bear1023/logistics-robot/(list of files, drawings)

Other design files:
hardware/easyeda/物流车.epro
