bear1023/logistics-robot/firmware/USER/main.c

#include "stm32f4xx.h"
#include "usart.h"
#include "delay.h"
#include "board.h"
#include "Emm_V5.h"
#include "uart6_ckp.h"
#include "Serial.h"
#include "yyb_move.h"
#include "imu.h"
#include "PWM.h"
#include "LED.h"
#include "OLED.h"
#include "swith.h"
#include "pid.h"
#include "usart5.h"
#include "wit_c_sdk.h"
#include "exti.h"

//x减物块右移（从外侧往内看）//y+物块往地图内侧走
//x加物块左移（从外侧往内看）//y-物块往地图外侧走
#define  x_center_red       955+1
#define  y_center_red		519-8

#define  x_center_green		955-3
#define  y_center_green		519-8

#define  x_center_blue		955+1
#define  y_center_blue		519-8

char tjcstr[100];
int acc[4];
float direct_x = 0;
float direct_y = 0;
float distance_wukuai = 150;
float x_origin = 0;
float y_origin = 0;
float time_zhua = 0;
int task[6]; //存储颜色信息
int ypcode[6]; //存储颜色信息
int move[6]; //存储移动信息
int test11 = 0;
float angle = 0;

void transfer_pi_position11(uint8_t task_num);
void transfer_pi_position12(uint8_t task_num);
void transfer_pi_position2(void);
void transfer_pi_position3(uint8_t task_num);
void fangzhi_green(void);
void fangzhi_red(void);
void fangzhi_blue(void);
void fangzhi(uint8_t task);
void fangzhi_maduo(uint8_t task);
void na(uint8_t task);
void yuantai_na(uint8_t task);
void yuantai_na1(uint8_t task);
void yuantai_na2(uint8_t task);
void wait_send_shumeipai(uint8_t message,uint16_t time);
void clear_ckp(void);
void jixie_reset(void);
char message[] = "Hello, BT - 04 from STM32F407!\r\n";
int main(void)
{	
/*
	所有的中断：
		1.OLED每隔500ms更新角度数据（最好不启用，里面耗时很长）（会影响delay函数的调用正确与否）
		2.delayms1函数在启用时最好关闭所有中断
		3.PID每间隔50ms进行一次PID计算，花25ms给所有电机发送指令（耗时中等）
		4.IMU每次接受信息触发一次中断
		5.树莓派给stm32发送信息时触发中断
		6.步进电机到位时发送信息中断
		7.舵机控制每隔20ms定时控制角度
*/
	delay_init(168);
	board_init();  //配置can总线协议
	LED_Init();  //配置LED指示灯
	OLED_Init();   //暂时不启用OLED //OLED中断和TIM5绑定在一起（两个必须同时用）
	Timer6_Init(); //delayms1的时钟
	PWM_Init();	  //使用定时器二，开启中断，实时控制舵机角度
	uart5_init(9600);
	uart6_init(9600);//串口屏用的UART6
	Serial_Init();	//通讯串口1初始化，用UART1
	Swith_Init();   //开关初始化
	imu_init();     //使用UART2
	PIDInit();		//用定时器实现定时中断//周期为50ms//该中断最好不要被别的中断打断
	Key_EXTI_Init();//按键中断//向树莓派发送重启命令
    clear_ckp();    //清空串口屏
	dianji_move_flag = 1;//使能电机的运动
	TIM_SetCompare1(TIM3,0);  //关闭补光灯
//**************************测试代码***************************//
//	while(1){
//		LED_Toggle2();
//		delay_ms1(200);
//		if((Serial_RxPacket[0]==0x39) && (Serial_RxPacket[1]==0x38)){
//			break;
//	    }
//	}
//	while(swith_out() == 1){		
//		LED_Toggle2();
//		delay_ms1(50);
//	}//树莓派已经准备好，按下开关即可启动
//	//复位到识别的位置
//	task[0] = 0x02;task[1] = 0x01;task[2] = 0x03;
//	TIM_SetCompare1(TIM3,300);
//	move_all1(-120.0f,1000,200   ,0,1000,200   ,278.0f,13);
//	set_zhuashou_Angle(50.0f,200);
//	while(1){
//		wait_send_shumeipai(0x37,10000);//如果发送了信息，但是一直没有得到回应，那么就一直发送
//		transfer_pi_position11(0x02);
//		car_move_distance(direct_x,direct_y,180,150);
//		if(Serial_RxPacket[8] != 0x34){
//			break;
//		}
//		//如果返回了没看到的信息，那就微微调整一下，再重复给树莓派发送
//		//反之如果返回了看到的信息（也即第九位并非0x34）,则可以退出该程序
//	}	
//	//精细定标
//	{
//		wait_send_shumeipai(0x38,10000);//如果发送了信息，但是一直没有得到回应，那么就一直发送
//		transfer_pi_position12(0x02);	
//		if(Serial_RxPacket[8] == 0x34){
//			car_move_distance(0,0,70,50);//如果没有看到颜色，那就不移动
//		}else{	
//			car_move_distance(direct_x,direct_y,130,100);//如果看到颜色，那就按照正常的方式移动
//		}
//	}//至此第二次定标完成
//	move_all(-48.0f,1000,200   ,33,1000,200   ,135,13);//物块平台抓物块
//	set_zhuashou_Angle(6.0f,200);
//	//放置第一个
//	fangzhi(task[0]);
//	set_wukuaipingtai_Angle(20.0f+113.0f,300);
//	delay_ms1((int)shengjiang_control(33,2000,240));
//	move_all(-48.0f,1000,200   ,33,1000,200   ,135,13);//物块平台抓物块
//	set_zhuashou_Angle(6.0f,200);
//	
//	//放置第二个	
//	fangzhi(task[1]);
//	
//	set_wukuaipingtai_Angle(20.0f+113.0f+117.0f,300);
//	delay_ms1((int)shengjiang_control(33,2000,240));
//	move_all(-48.0f,1000,200   ,33,2000,200   ,135,13);//物块平台抓物块
//	set_zhuashou_Angle(6.0f,200);
//	
//	//放置第三个	
//	fangzhi(task[2]);
//	jixie_reset();//*****************
//*************************第一轮*************************//
	while(1){
		LED_Toggle2();
		delay_ms1(200);
		if((Serial_RxPacket[0]==0x39) && (Serial_RxPacket[1]==0x38)){
			break;
	    }
	}
//	test11 = WHT101_HUIFUHCUCHANG();
//	test11 = WHT101_SETBAUD();
//	test11 = WHT101_SETOUTRATE();
//**************************指示灯闪烁，可以开始***************************//
	while(swith_out() == 1){		
		LED_Toggle2();
		delay_ms1(50);
	}//树莓派已经准备好，按下开关即可启动
	mypid.integral = 0;
	WHT101_ANGLEZCali();//101z轴置零
	Serial_GetRxFlag();Serial_SendByte(0x31);
//***************************第一部分，识别二维码并显示，大致移动到原料区*********************//	
	//扫二维码
	car_move2(150,0,150,150);
	car_move1(0,-530,150,200);
    //读取树莓派信息	
	while(1){
		if (Serial_GetRxFlag() == 1){   //收到数据包
			   sprintf(tjcstr, "t0.txt=\"%d%d%d+%d%d%d \"",
										Serial_RxPacket[0]-0x30,Serial_RxPacket[1]-0x30,Serial_RxPacket[2]-0x30,
										Serial_RxPacket[4]-0x30,Serial_RxPacket[5]-0x30,Serial_RxPacket[6]-0x30);
				HMISends(tjcstr);
	            HMISendb(0xff);//在显示屏上面显示任务
				break;
			  }
	}	
    task[0]= Serial_RxPacket[0]-0x30;task[1] = Serial_RxPacket[1]-0x30;task[2] = Serial_RxPacket[2]-0x30;
	task[3]= Serial_RxPacket[4]-0x30;task[4] = Serial_RxPacket[5]-0x30;task[5] = Serial_RxPacket[6]-0x30;
	set_wukuaipingtai_Angle(20.0f,300);
//********************第二部分，识别物块颜色，按照指定的顺序搬运**************************//
	//复位到识别的位置
	move_all1(-120.0f,1000,200   ,0,2000,200   ,278,13);
	set_zhuashou_Angle(60.0f,300);
	car_move1(0,-1000+90,150,200);
	move_all1(40.0f,1000,200   ,0,2000,200   ,278,13);
	Serial_GetRxFlag();Serial_SendByte(0x32);
	car_move2(-30,0,100,100);	
	TIM_SetCompare1(TIM3,300);
	while(1){
		while(1){
			if(Serial_GetRxFlag() == 1){
				break;
			}
		}
		transfer_pi_position2();
		car_move_distance(direct_x,direct_y,100,80);//至此第一次定标完成
		if(Serial_RxPacket[8] != 0x34){
			break;
		}else{
			wait_send_shumeipai(0x32,15000);
		}
	}
	move_all(60.0f,1000,200   ,0,2000,200   ,278,13);
	wait_send_shumeipai(0x33,20000);
	ypcode[0]= Serial_RxPacket[0]-0x30;ypcode[1] = Serial_RxPacket[1]-0x30;ypcode[2] = Serial_RxPacket[2]-0x30;
	TIM_SetCompare1(TIM3,300);
	//拿走第一个物块
	yuantai_na(ypcode[0]);
	set_wukuaipingtai_Angle(20.0f+113.0f,300);
	
	//拿走第二个物块
	yuantai_na1(ypcode[1]);
	
	wait_send_shumeipai(0x35,30000);
	while(1){
		if(Serial_RxPacket[0] == 0x39 && Serial_RxPacket[1] == 0x38){
			break;
		}
	}Serial_RxPacket[0] = 0x30;Serial_RxPacket[1] = 0x30;
	
	yuantai_na2(ypcode[1]);
	set_wukuaipingtai_Angle(20.0f+113.0f+117.0f,300);
		
	//拿走第三个物块
	yuantai_na1(ypcode[2]); 
	
	wait_send_shumeipai(0x36,30000);
	while(1){
		if(Serial_RxPacket[0] == 0x39 && Serial_RxPacket[1] == 0x38){
			break;
		}
	}Serial_RxPacket[0] = 0x30;Serial_RxPacket[1] = 0x30;	
	
	yuantai_na2(ypcode[2]);

	TIM_SetCompare1(TIM3,0);
	//复位到识别的位置
	set_wukuaipingtai_Angle(20.0f,300);
	move_all1(-120.0f,1000,200   ,0,1000,200   ,278.0f,13);
	set_zhuashou_Angle(50.0f,200);
//***************************到下一个区域**************************//	
	//到粗加工区
	PID_move(-30,0,0,400,0,1);//回倒车
	delay_ms1(200);
	car_move1(0,400,150,200);
	
	mypid.integral = 0;PID_move(0,0,0,1000,90,0);//在原地旋转
	PID_move(0,0,0,1000,90,3);
	
	car_move1(0,-1700,150,250);//快速通过
	
	mypid.integral = 0;PID_move(0,0,0,1000,-180,0);//在粗加工区原地旋转
	PID_move(0,0,0,1000,-180,3);
//****************************调整(亮度等参数)****************************//
	TIM_SetCompare1(TIM3,300);
//*************************第三部分，色环位置拿并放置**********************//
	while(1){
		wait_send_shumeipai(0x37,10000);//如果发送了信息，但是一直没有得到回应，那么就一直发送
		transfer_pi_position11(0x02);
		car_move_distance(direct_x,direct_y,180,150);
		if(Serial_RxPacket[8] != 0x34){
			break;
		}
		//如果返回了没看到的信息，那就微微调整一下，再重复给树莓派发送
		//反之如果返回了看到的信息（也即第九位并非0x34）,则可以退出该程序
	}
	
	//角度校正
	PID_move(0,0,0,1000,-180.0f,4);
	
	//精细定标
	{
		wait_send_shumeipai(0x38,10000);//如果发送了信息，但是一直没有得到回应，那么就一直发送
		transfer_pi_position12(0x02);	
		if(Serial_RxPacket[8] == 0x34){
			car_move_distance(0,0,70,50);//如果没有看到颜色，那就不移动
		}else{	
			car_move_distance(direct_x,direct_y,130,100);//如果看到颜色，那就按照正常的方式移动
		}
	}//至此第二次定标完成
	
	move_all(-48.0f,1000,200   ,33,1000,200   ,135,13);//物块平台抓物块
	set_zhuashou_Angle(6.0f,200);
	//放置第一个
	fangzhi(task[0]);	
	set_wukuaipingtai_Angle(20.0f+113.0f,300);
	delay_ms1((int)shengjiang_control(33,2000,240));
	move_all(-48.0f,1000,200   ,33,1000,200   ,135,13);//物块平台抓物块
	set_zhuashou_Angle(6.0f,200);
	
	//放置第二个	
	fangzhi(task[1]);
	
	set_wukuaipingtai_Angle(20.0f+113.0f+117.0f,300);
	delay_ms1((int)shengjiang_control(33,2000,240));
	move_all(-48.0f,1000,200   ,33,2000,200   ,135,13);//物块平台抓物块
	set_zhuashou_Angle(6.0f,200);
	
	//放置第二个	
	fangzhi(task[2]);
//	jixie_reset();//*****************
	set_wukuaipingtai_Angle(20.0f,300);
	//拿一
	na(task[0]);
	set_wukuaipingtai_Angle(20.0f+113.0f,300);
	//拿二
	na(task[1]);
	set_wukuaipingtai_Angle(20.0f+113.0f+117.0f,300);
	//拿三
	na(task[2]);
	//复位到识别的位置
	set_wukuaipingtai_Angle(20.0f,300);
	move_all1(-120.0f,1000,200   ,0,1000,200   ,278,13);
	set_zhuashou_Angle(50.0f,200);
//*************************到下一个区域***************************//	
	PID_move(-30,0,0,300,-180,1);//在粗加工区回退
	PID_move(0,0,0,500,-180,3);
	car_move1(140,140+680,180,180);//从绿色出发
	delay_ms1(100);
	
	mypid.integral = 0;PID_move(0,0,0,1000,90,0);
	PID_move(0,0,0,1000,90,3);
	
	car_move1(140,140+620,180,150);
//****************************调整(亮度等参数)****************************//
	TIM_SetCompare1(TIM3,300);
//*************************第四部分，色环位置放置**********************//
	while(1){
		wait_send_shumeipai(0x37,10000);//如果发送了信息，但是一直没有得到回应，那么就一直发送
		transfer_pi_position11(0x02);
		car_move_distance(direct_x,direct_y,180,150);
		if(Serial_RxPacket[8] != 0x34){
			break;
		}
		//如果返回了没看到的信息，那就微微调整一下，再重复给树莓派发送
		//反之如果返回了看到的信息（也即第九位并非0x34）,则可以退出该程序
	}
		//角度校正
	wait_send_shumeipai(0x64,10000);
	angle = (Serial_RxPacket[7]-0x30) + (Serial_RxPacket[8]-0x30)*0.1f;
	if(ABS(angle) >= 2.0f){
		angle = 2.0f;
	}
	if((Serial_RxPacket[6]-0x30) == 0){
		angle = -angle;
	}
	PID_move(0,0,0,1000,90-angle,4);
	
	//精细定标
	{
		wait_send_shumeipai(0x38,10000);//如果发送了信息，但是一直没有得到回应，那么就一直发送
		transfer_pi_position12(0x02);	
		if(Serial_RxPacket[8] == 0x34){
			car_move_distance(0,0,70,50);//如果没有看到颜色，那就不移动
		}else{	
			car_move_distance(direct_x,direct_y,130,100);//如果看到颜色，那就按照正常的方式移动
		}
	}//至此第二次定标完成
	
	move_all(-48.0f,1000,200   ,33,1000,200   ,135,13);//物块平台抓物块
	set_zhuashou_Angle(6.0f,200);
	//放置第一个
	fangzhi(task[0]);
	
//	jixie_reset();//**************************************************
	
	set_wukuaipingtai_Angle(20.0f+113.0f,300);
	delay_ms1((int)shengjiang_control(33,2000,240));
	move_all(-48.0f,1000,200   ,33,1000,200   ,135,13);//物块平台抓物块
	set_zhuashou_Angle(6.0f,200);
	
	//放置第二个	
	fangzhi(task[1]);
	
	set_wukuaipingtai_Angle(20.0f+113.0f+117.0f,300);
	delay_ms1((int)shengjiang_control(33,2000,240));
	move_all(-48.0f,1000,200   ,33,2000,200   ,135,13);//物块平台抓物块
	set_zhuashou_Angle(6.0f,200);
	
	//放置第三个	
	fangzhi(task[2]);
	//复位到识别的位置
	set_wukuaipingtai_Angle(20.0f,300);
	move_all1(-120.0f,1000,200   ,0,1000,200   ,278,13);
	set_zhuashou_Angle(50.0f,200);
//*************************第五部分，回到圆盘**********************//
	PID_move(-30,0,0,300,90,1);//回退
	delay_ms1(100);
	//回到原料
	car_move1(140,220+650,180,180);//从绿色出发
	
	mypid.integral = 0;PID_move(0,0,0,1000,0,0);
	PID_move(0,0,0,1000,0,3);
	
	car_move1(140,370+20,180,180);
	move_all1(40.0f,1000,200   ,0,2000,200   ,278,13);
	Serial_GetRxFlag();Serial_SendByte(0x61);
	PID_move(30,0,0,300,0,1);//在粗加工区往前靠
	delay_ms1(100);	
//*****************************第二轮**************************//
//	jixie_reset();
//********************第二部分，识别物块颜色，按照指定的顺序搬运**************************//
	TIM_SetCompare1(TIM3,300);
	while(1){
		while(1){
			if(Serial_GetRxFlag() == 1){
				break;
			}
		}
		transfer_pi_position2();
		car_move_distance(direct_x,direct_y,100,80);//至此第一次定标完成
		if(Serial_RxPacket[8] != 0x34){
			break;
		}else{
			wait_send_shumeipai(0x61,15000);
		}
	}
	move_all(60.0f,1000,200   ,0,2000,200   ,278,13);
	wait_send_shumeipai(0x34,20000);
	
	ypcode[0]= Serial_RxPacket[0]-0x30;ypcode[1] = Serial_RxPacket[1]-0x30;ypcode[2] = Serial_RxPacket[2]-0x30;
	TIM_SetCompare1(TIM3,300);
	//拿走第一个物块
	yuantai_na(ypcode[0]);
	set_wukuaipingtai_Angle(20.0f+113.0f,300);
	
	//拿走第二个物块
	yuantai_na1(ypcode[1]);
	
	wait_send_shumeipai(0x62,30000);
	while(1){
		if(Serial_RxPacket[0] == 0x39 && Serial_RxPacket[1] == 0x38){
			break;
		}
	}Serial_RxPacket[0] = 0x30;Serial_RxPacket[1] = 0x30;
	
	yuantai_na2(ypcode[1]);
	set_wukuaipingtai_Angle(20.0f+113.0f+117.0f,300);
		
	//拿走第三个物块
	yuantai_na1(ypcode[2]); 
	
	wait_send_shumeipai(0x63,30000);
	while(1){
		if(Serial_RxPacket[0] == 0x39 && Serial_RxPacket[1] == 0x38){
			break;
		}
	}Serial_RxPacket[0] = 0x30;Serial_RxPacket[1] = 0x30;	
	
	yuantai_na2(ypcode[2]);
	TIM_SetCompare1(TIM3,0);
	//复位到识别的位置
	set_wukuaipingtai_Angle(20.0f,300);
	move_all1(-120.0f,1000,200   ,0,1000,200   ,278,13);
	set_zhuashou_Angle(50.0f,200);
//***************************到下一个区域**************************//	
	//到粗加工区
	PID_move(-30,0,0,400,0,1);//回倒车
	delay_ms1(200);
	car_move1(0,400,150,200);
	
	mypid.integral = 0;PID_move(0,0,0,1000,90,0);//在原地旋转
	PID_move(0,0,0,1000,90,3);
	
	car_move1(0,-1700,150,250);//快速通过
	
	mypid.integral = 0;PID_move(0,0,0,1000,-180,0);//在粗加工区原地旋转
	PID_move(0,0,0,1000,-180,3);
//****************************调整(亮度等参数)****************************//
	TIM_SetCompare1(TIM3,300);
//*************************第三部分，色环位置拿并放置**********************//
	while(1){
		wait_send_shumeipai(0x37,20000);//如果发送了信息，但是一直没有得到回应，那么就一直发送
		transfer_pi_position11(0x02);
		car_move_distance(direct_x,direct_y,180,150);
		if(Serial_RxPacket[8] != 0x34){
			break;
		}
		//如果返回了没看到的信息，那就微微调整一下，再重复给树莓派发送
		//反之如果返回了看到的信息（也即第九位并非0x34）,则可以退出该程序
	}
	
	//角度校正
	wait_send_shumeipai(0x64,10000);
	angle = (Serial_RxPacket[7]-0x30) + (Serial_RxPacket[8]-0x30)*0.1f;
	if(ABS(angle) >= 2.0f){
		angle = 2.0f;
	}
	if((Serial_RxPacket[6]-0x30) == 0){
		angle = -angle;
	}
	PID_move(0,0,0,1000,-180-angle,4);
	
	//精细定标
	{
		wait_send_shumeipai(0x38,20000);//如果发送了信息，但是一直没有得到回应，那么就一直发送
		transfer_pi_position12(0x02);	
		if(Serial_RxPacket[8] == 0x34){
			car_move_distance(0,0,70,50);//如果没有看到颜色，那就不移动
		}else{	
			car_move_distance(direct_x,direct_y,130,100);//如果看到颜色，那就按照正常的方式移动
		}
	}//至此第二次定标完成
	
	move_all(-48.0f,1000,200   ,33,1000,200   ,135,13);//物块平台抓物块
	set_zhuashou_Angle(6.0f,200);
	//放置第一个
	fangzhi(task[3]);
	set_wukuaipingtai_Angle(20.0f+113.0f,300);
	delay_ms1((int)shengjiang_control(33,2000,240));
	move_all(-48.0f,1000,200   ,33,1000,200   ,135,13);//物块平台抓物块
	set_zhuashou_Angle(6.0f,200);
	
	//放置第二个	
	fangzhi(task[4]);
	
	set_wukuaipingtai_Angle(20.0f+113.0f+117.0f,300);
	delay_ms1((int)shengjiang_control(33,2000,240));
	move_all(-48.0f,1000,200   ,33,2000,200   ,135,13);//物块平台抓物块
	set_zhuashou_Angle(6.0f,200);
	
	//放置第二个	
	fangzhi(task[5]);
	set_wukuaipingtai_Angle(20.0f,300);
	//拿一
	na(task[3]);
	set_wukuaipingtai_Angle(20.0f+113.0f,300);
	//拿二
	na(task[4]);
	set_wukuaipingtai_Angle(20.0f+113.0f+117.0f,300);
	//拿三
	na(task[5]);
	set_wukuaipingtai_Angle(20.0f,300);
	move_all1(-120.0f,1000,200   ,0,1000,200   ,278,13);
	set_zhuashou_Angle(50.0f,200);
//*************************到下一个区域***************************//	
	PID_move(-30,0,0,300,-180,1);//在粗加工区回退
	PID_move(0,0,0,500,-180,3);
	car_move1(140,140+680,180,180);//从绿色出发
	delay_ms1(100);
	
	mypid.integral = 0;PID_move(0,0,0,1000,90,0);
	PID_move(0,0,0,1000,90,3);
	
	car_move1(140,140+620,180,150);
//****************************调整(亮度等参数)****************************//
	TIM_SetCompare1(TIM3,300);
//********************************码垛****************************
	while(1){
		wait_send_shumeipai(0x39,10000);	
		transfer_pi_position3(0x02);
		car_move_distance(direct_x,direct_y,180,150);//至此第一次定标完成
		delay_ms1(200);
		if(Serial_RxPacket[8] != 0x34){
			break;
		}
	}
	{
		wait_send_shumeipai(0x39,10000);		
		transfer_pi_position3(0x02);	
		if(Serial_RxPacket[8] == 0x34){
			car_move_distance(0,0,70,50);
		}else{	
			car_move_distance(direct_x,direct_y,180,150);//至此第二次定标完成
		}
	}
	move_all(-48.0f,1000,200   ,33,1000,200   ,135,13);//物块平台抓物块
	set_zhuashou_Angle(6.0f,200);
	//放置第一个
	fangzhi_maduo(task[3]);
	set_wukuaipingtai_Angle(20.0f+113.0f,300);
	delay_ms1((int)shengjiang_control(33,2000,240));
	move_all(-48.0f,1000,200   ,33,1000,200   ,135,13);//物块平台抓物块
	set_zhuashou_Angle(6.0f,200);
	
	//放置第二个	
	fangzhi_maduo(task[4]);
	
	set_wukuaipingtai_Angle(20.0f+113.0f+117.0f,300);
	delay_ms1((int)shengjiang_control(33,2000,240));
	move_all(-48.0f,1000,200   ,33,2000,200   ,135,13);//物块平台抓物块
	set_zhuashou_Angle(6.0f,200);
	
	//放置第三个	
	fangzhi_maduo(task[5]);
	set_wukuaipingtai_Angle(20.0f,300);
	//回到启停区
	PID_move(-30,0,0,300,90,1);//回退
	move_all(0.0f,1000,200   ,0,1000,200   ,64.8,13);
	car_move1(140,220+650,180,180);//从绿色出发
	mypid.integral = 0;PID_move(0,0,0,1300,0,0);
	car_move1(140,2000-150,180,180);
	car_move2(-130,0,150,150);//在粗加工区往前靠
	jixie_reset();
}

//定时显示OLED和LCD显示屏
void TIM5_IRQHandler(void)
{
	if (TIM_GetITStatus(TIM5, TIM_IT_Update) == SET)
	{   
		imu_scan(fAcc, fGyro, fAngle);
		TIM_ClearITPendingBit(TIM5, TIM_IT_Update);
		OLED_ShowSignedNum(1,1,fAngle[2],3);
		OLED_ShowChar(1,5,'.');
		OLED_ShowNum(1,6,ABS((fAngle[2]-(int)fAngle[2])*1000),3);
		OLED_ShowSignedNum(2,1,angle,3);
		OLED_ShowChar(2,5,'.');
		OLED_ShowNum(2,6,ABS((angle-(int)angle)*1000),3);
		
	}
}

//与任务码相关联，放置的第一个物块定标用//第一轮放置1
void transfer_pi_position11(uint8_t task_num)
{   
	x_origin = (Serial_RxPacket[0]-0x30)*1000+(Serial_RxPacket[1]-0x30)*100+(Serial_RxPacket[2]-0x30)*10+(Serial_RxPacket[3]-0x30);
	y_origin = (Serial_RxPacket[4]-0x30)*1000+(Serial_RxPacket[5]-0x30)*100+(Serial_RxPacket[6]-0x30)*10+(Serial_RxPacket[7]-0x30);
	float x_center,y_center;//x加物块右移//y+物块下移
	if(Serial_RxPacket[8] == 0x31){
		x_center = x_center_red;y_center = y_center_red;
	}else if(Serial_RxPacket[8] == 0x32){
		x_center = x_center_green;y_center = y_center_green;
	}else if(Serial_RxPacket[8] == 0x33){
		x_center = x_center_blue;y_center = y_center_blue;
	}
	x_center =316;y_center =238;
	x_origin = x_origin - x_center;
	y_origin = y_origin - y_center;
	
	direct_x = x_origin * 1.1805555;    //实际尺寸系数
	direct_y = y_origin * 1.1805555;
	if(task_num == 2){
		if(Serial_RxPacket[8] == 0x32){
		}else if(Serial_RxPacket[8] == 0x31){
				direct_x = direct_x + distance_wukuai;
		}else if(Serial_RxPacket[8] == 0x33){
				direct_x = direct_x - distance_wukuai;
		}else if(Serial_RxPacket[8] == 0x34){
				direct_y = 3;direct_x = -3;
		}
	}else if(task_num == 1){
		if(Serial_RxPacket[8] == 0x31){
		}else if(Serial_RxPacket[8] == 0x32){
			direct_x = direct_x - distance_wukuai;
		}else if(Serial_RxPacket[8] == 0x33){
				direct_x = direct_x - 2*distance_wukuai;
		}else if(Serial_RxPacket[8] == 0x34){
				direct_y = 3;direct_x = -3;
		}
	}else if(task_num == 3){
		if(Serial_RxPacket[8] == 0x33){
		}else if(Serial_RxPacket[8] == 0x32){
			direct_x = direct_x + distance_wukuai;
		}else if(Serial_RxPacket[8] == 0x31){
				direct_x = direct_x + 2*distance_wukuai;
		}else if(Serial_RxPacket[8] == 0x34){
				direct_y = 3;direct_x = -3;
		}
	}
}


//与任务码相关联，放置的第一个物块定标用//第一轮放置2
void transfer_pi_position12(uint8_t task_num)
{   
	x_origin = (Serial_RxPacket[0]-0x30)*1000+(Serial_RxPacket[1]-0x30)*100+(Serial_RxPacket[2]-0x30)*10+(Serial_RxPacket[3]-0x30);
	y_origin = (Serial_RxPacket[4]-0x30)*1000+(Serial_RxPacket[5]-0x30)*100+(Serial_RxPacket[6]-0x30)*10+(Serial_RxPacket[7]-0x30);
	float x_center,y_center;//x加物块右移//y+物块下移
	if(Serial_RxPacket[8] == 0x31){
		x_center = x_center_red;y_center = y_center_red;
	}else if(Serial_RxPacket[8] == 0x32){
		x_center = x_center_green;y_center = y_center_green;
	}else if(Serial_RxPacket[8] == 0x33){
		x_center = x_center_blue;y_center = y_center_blue;
	}
	x_origin = x_origin - x_center;
	y_origin = y_origin - y_center;
	
	direct_x = x_origin * 0.29239766;    //实际尺寸系数
	direct_y = y_origin * 0.29239766;
	if(task_num == 2){
		if(Serial_RxPacket[8] == 0x32){
		}else if(Serial_RxPacket[8] == 0x31){
				direct_x = direct_x + distance_wukuai;
		}else if(Serial_RxPacket[8] == 0x33){
				direct_x = direct_x - distance_wukuai;
		}else if(Serial_RxPacket[8] == 0x34){
				direct_y = 3;direct_x = -3;
		}
	}else if(task_num == 1){
		if(Serial_RxPacket[8] == 0x31){
		}else if(Serial_RxPacket[8] == 0x32){
			direct_x = direct_x - distance_wukuai;
		}else if(Serial_RxPacket[8] == 0x33){
				direct_x = direct_x - 2*distance_wukuai;
		}else if(Serial_RxPacket[8] == 0x34){
				direct_y = 3;direct_x = -3;
		}
	}else if(task_num == 3){
		if(Serial_RxPacket[8] == 0x33){
		}else if(Serial_RxPacket[8] == 0x32){
			direct_x = direct_x + distance_wukuai;
		}else if(Serial_RxPacket[8] == 0x31){
				direct_x = direct_x + 2*distance_wukuai;
		}else if(Serial_RxPacket[8] == 0x34){
				direct_y = 3;direct_x = -3;
		}
	}
}

//代表圆盘中心检测
//只计算中心，不辨别颜色
void transfer_pi_position2(void)
{   
	x_origin = (Serial_RxPacket[0]-0x30)*1000+(Serial_RxPacket[1]-0x30)*100+(Serial_RxPacket[2]-0x30)*10+(Serial_RxPacket[3]-0x30);
	y_origin = (Serial_RxPacket[4]-0x30)*1000+(Serial_RxPacket[5]-0x30)*100+(Serial_RxPacket[6]-0x30)*10+(Serial_RxPacket[7]-0x30);
	float x_center,y_center;//x加物块右移//y+物块下移
	x_origin = x_origin - 322;
	y_origin = y_origin - 165;
	
	direct_x = x_origin * 0.6756;    //实际尺寸系数
	direct_y = y_origin * 0.6756;
	if(Serial_RxPacket[8] == 0x34){
		direct_y = 5;direct_x = -5;
	}
}

//与任务码相关联，放置的第一个物块定标用//第二轮放置
void transfer_pi_position3(uint8_t task_num)
{   
	x_origin = (Serial_RxPacket[0]-0x30)*1000+(Serial_RxPacket[1]-0x30)*100+(Serial_RxPacket[2]-0x30)*10+(Serial_RxPacket[3]-0x30);
	y_origin = (Serial_RxPacket[4]-0x30)*1000+(Serial_RxPacket[5]-0x30)*100+(Serial_RxPacket[6]-0x30)*10+(Serial_RxPacket[7]-0x30);
	float x_center,y_center;//x加物块右移//y+物块下移
	if(Serial_RxPacket[8] == 0x31){
		x_center = x_center_red;y_center = y_center_red;
	}else if(Serial_RxPacket[8] == 0x32){
		x_center = x_center_green;y_center = y_center_green;
	}else if(Serial_RxPacket[8] == 0x33){
		x_center = x_center_blue;y_center = y_center_blue;
	}
	x_origin = x_origin - 314;
	y_origin = y_origin - 238;
	
	direct_x = x_origin * 0.96153846;    //实际尺寸系数
	direct_y = y_origin * 0.96153846;
	if(task_num == 2){
		if(Serial_RxPacket[8] == 0x32){
		}else if(Serial_RxPacket[8] == 0x31){
				direct_x = direct_x + distance_wukuai;
		}else if(Serial_RxPacket[8] == 0x33){
				direct_x = direct_x - distance_wukuai;
		}else if(Serial_RxPacket[8] == 0x34){
				direct_y = 5;direct_x = -5;
		}
	}else if(task_num == 1){
		if(Serial_RxPacket[8] == 0x31){
		}else if(Serial_RxPacket[8] == 0x32){
			direct_x = direct_x - distance_wukuai;
		}else if(Serial_RxPacket[8] == 0x33){
				direct_x = direct_x - 2*distance_wukuai;
		}else if(Serial_RxPacket[8] == 0x34){
				direct_y = 5;direct_x = -5;
		}
	}else if(task_num == 3){
		if(Serial_RxPacket[8] == 0x33){
		}else if(Serial_RxPacket[8] == 0x32){
			direct_x = direct_x + distance_wukuai;
		}else if(Serial_RxPacket[8] == 0x31){
				direct_x = direct_x + 2*distance_wukuai;
		}else if(Serial_RxPacket[8] == 0x34){
				direct_y = 5;direct_x = -5;
		}
	}
}


void clear_ckp(void)
{
	sprintf(tjcstr, "t0.txt=\"  \"");
			HMISends(tjcstr);
	        HMISendb(0xff);//在显示屏上面显示任务
}

/*
	先发送命令，等待一段时间如果还没有返回
	则继续发送，直到收到信息，立刻退出
*/
void wait_send_shumeipai(uint8_t message,uint16_t time)
{	
	Serial_GetRxFlag();//清空标志位
	Serial_SendByte(message);
	while(1){
		if(Serial_GetRxFlag() == 1){
			break;
		}
	}
}

void jixie_reset(void)
{	
	while(swith_out() == 1){		
		LED_Toggle2();
		delay_ms1(50);
	}
	set_zhuashou_Angle(50.0f,300);
	move_all(0.0f,1000,200   ,0,1000,200   ,68.2,13);
	set_wukuaipingtai_Angle(20.0f,300);
	USART_ITConfig(USART2, USART_IT_RXNE, ENABLE);
	TIM_Cmd(TIM5, ENABLE); 
	while(1){}
}

void fangzhi_green(void)
{
	move_all(-48.0f,1000,200   ,25,1000,200   ,135,13);
	move_all(-20.0f,1000,200   ,25,1000,200   ,135,13);
	move_all(-20.0f,1000,200   ,25,1000,200   ,278.0f,13);
	move_all(-50.0f,1000,200   ,132,1000,200   ,278.0f,13);
	set_zhuashou_Angle(50.0f,300);
}

void fangzhi_red(void)
{
	move_all(-48.0f,1000,200   ,25,1000,200   ,135,13);
	move_all(3.0f+3.0f,1000,200   ,25,1000,200   ,236.3f,13);
	move_all(3.0f+3.0f,1000,200   ,132,1000,200   ,236.3f,13);
	set_zhuashou_Angle(50.0f,300);
}
void fangzhi_blue(void)
{
	move_all(-48.0f,1000,200   ,25,1000,200   ,135,13);
	move_all(3.0f+4.0f,1000,200   ,25,1000,200   ,317.0f+2.4f,13);
	move_all(3.0f+4.0f,1000,200   ,132,1000,200   ,317.0f+2.4f,13);
	set_zhuashou_Angle(50.0f,300);
}

void fangzhi(uint8_t task)
{
	if(task == 0x01){
		fangzhi_red();
	}else if(task == 0x02){
		fangzhi_green();
	}else if(task == 0x03){
		fangzhi_blue();
	}
}

void fangzhi_maduo(uint8_t task)
{
	if(task == 0x01){
		move_all(-48.0f,1000,200   ,25,1000,200   ,135,13);
		move_all(3.0f,1000,200   ,25,1000,200   ,236,13);
		move_all(3.0f,1000,200   ,130-70-1,1000,200   ,236,13);
		set_zhuashou_Angle(50.0f,300);
	}else if(task == 0x02){
		move_all(-48.0f,1000,200   ,25,1000,200   ,135,13);
		move_all(-48.0f,1000,200   ,25,1000,200   ,180,13);
		move_all(-120.0f,1000,200   ,25,1000,200   ,278,13);
		move_all(-50.0f,1000,200   ,130-70-1,1000,200   ,278,13);
		set_zhuashou_Angle(50.0f,300);
	}else if(task == 0x03){
		move_all(-48.0f,1000,200   ,25,1000,200   ,135,13);
		move_all(-48.0f,1000,200   ,25,1000,200   ,180,13);
		move_all(-120.0f,1000,200   ,25,1000,200   ,317,13);
		move_all(3.0f,1000,200   ,130-70-1,1000,200   ,317,13);
		set_zhuashou_Angle(50.0f,300);
	}
}

void na_green(void)
{	
	move_all(-10.0f,1000,200   ,130,1000,200   ,278,13);
	move_all(-50.0f,1000,200   ,130,1000,200   ,278,13);
	set_zhuashou_Angle(6.0f,200);
	move_all(-50.0f,1000,200   ,50,1000,220   ,278,13);
	move_all(-48.0f,1000,200   ,25,1000,220   ,135,13);
	move_all(-48.0f,1000,200   ,33,1000,220   ,135,13);
	set_zhuashou_Angle(50.0f,200);
}

void na_blue(void)
{
	move_all(3.0f,1000,200   ,110,1000,200   ,317,13);
	move_all(3.0f,1000,200   ,130,1000,200   ,317,13);
	set_zhuashou_Angle(6.0f,200);
	move_all(8.0f,1000,200   ,25,1000,220   ,317,13);
	move_all(-48.0f,1000,200   ,25,1000,220   ,135,13);
	move_all(-48.0f,1000,200   ,33,1000,220   ,135,13);
	set_zhuashou_Angle(50.0f,200);
}

void na_red(void)
{
	move_all(3.0f,1000,200   ,130,1000,200   ,236,13);
	set_zhuashou_Angle(6.0f,200);
	move_all(-50.0f,1000,200   ,50,1000,220   ,236,13);
	move_all(-48.0f,1000,200   ,25,1000,220   ,135,13);
	move_all(-48.0f,1000,200   ,33,1000,220   ,135,13);
	set_zhuashou_Angle(50.0f,200);
}

void na(uint8_t task)
{
	if(task == 0x01){
		na_red();
	}else if(task == 0x02){
		na_green();
	}else if(task == 0x03){
		na_blue();
	}
}

void yuantai_na(uint8_t task)
{
	if(task == 0x01){
//		TIM_SetCompare1(TIM3,150);
		set_zhuashou_Angle(60.0f,300);   time_zhua += 350;
		time_zhua += move_all(-100.0f,1000,220   ,50,2000,220   ,278,13);
		set_zhuashou_Angle(6.0f,300);    time_zhua += 350;
		time_zhua += move_all(-48.0f,1000,200   ,25,2000,220   ,135,13);
		time_zhua += move_all(-48.0f,1000,200   ,33,2000,220   ,135,13);
		set_zhuashou_Angle(60.0f,300);	 time_zhua += 350;
	}else if(task == 0x02){
		set_zhuashou_Angle(60.0f,300);	 time_zhua += 350;
		time_zhua += move_all(63.0f,1000,200   ,48,2000,220   ,295,13);
		set_zhuashou_Angle(6.0f,300);    time_zhua += 350;
		time_zhua += move_all(20.0f,1000,200   ,25,2000,220   ,295,13);//**********多一个回收的动作
		time_zhua += move_all(-20.0f,1000,200   ,25,2000,220   ,135,13);
		time_zhua += move_all(-48.0f,1000,200   ,25,2000,220   ,135,13);
		time_zhua += move_all(-48.0f,1000,200   ,33,2000,220   ,135,13);
		set_zhuashou_Angle(60.0f,300);   time_zhua += 350;
	}else if(task == 0x03){
		set_zhuashou_Angle(60.0f,300);   time_zhua += 350;
		time_zhua += move_all(63.0f,1000,200   ,48,2000,220   ,261,13);
		set_zhuashou_Angle(6.0f,300);    time_zhua += 350;
		time_zhua += move_all(-48.0f,1000,200   ,25,2000,220   ,135,13);
		time_zhua += move_all(-48.0f,1000,200   ,33,2000,220   ,135,13);
		set_zhuashou_Angle(60.0f,300);   time_zhua += 350;
	}
}

void yuantai_na1(uint8_t task)
{
	if(task == 0x01){
		set_zhuashou_Angle(60.0f,300);   time_zhua += 350;
		time_zhua += move_all(40.0f,1000,200   ,0,2000,200   ,278,13);
	}else if(task == 0x02){
		set_zhuashou_Angle(60.0f,300);	 time_zhua += 350;
		time_zhua += move_all(63.0f,1000,200   ,18,2000,220   ,295,13);
	}else if(task == 0x03){
		set_zhuashou_Angle(60.0f,300);   time_zhua += 350;
		time_zhua += move_all(63.0f,1000,200   ,18,2000,220   ,261,13);
	}
}

void yuantai_na2(uint8_t task)
{
	if(task == 0x01){
		time_zhua += move_all(-100.0f,1000,220   ,50,2000,220   ,278,13);
		set_zhuashou_Angle(6.0f,300);    time_zhua += 350;
		time_zhua += move_all(-48.0f,1000,200   ,25,2000,220   ,135,13);
		time_zhua += move_all(-48.0f,1000,200   ,33,2000,220   ,135,13);
		set_zhuashou_Angle(60.0f,300);	 time_zhua += 350;
//		move_all(-120.0f,1000,200   ,0,2000,200   ,278,13);
	}else if(task == 0x02){
		time_zhua += move_all(63.0f,1000,200   ,48,2000,220   ,295,13);
		set_zhuashou_Angle(6.0f,300);    time_zhua += 350;
		time_zhua += move_all(20.0f,1000,200   ,25,2000,220   ,295,13);//**********多一个回收的动作
		time_zhua += move_all(-20.0f,1000,200   ,25,2000,220   ,135,13);
		time_zhua += move_all(-48.0f,1000,200   ,25,2000,220   ,135,13);
		time_zhua += move_all(-48.0f,1000,200   ,33,2000,220   ,135,13);
		set_zhuashou_Angle(60.0f,300);   time_zhua += 350;
//		move_all(-120.0f,1000,200   ,0,2000,200   ,278,13);
	}else if(task == 0x03){
		time_zhua += move_all(63.0f,1000,200   ,48,2000,220   ,261,13);
		set_zhuashou_Angle(6.0f,300);    time_zhua += 350;
		time_zhua += move_all(-48.0f,1000,200   ,25,2000,220   ,135,13);
		time_zhua += move_all(-48.0f,1000,200   ,33,2000,220   ,135,13);
		set_zhuashou_Angle(60.0f,300);   time_zhua += 350;
//		move_all(-120.0f,1000,200   ,0,2000,200   ,278,13);
	}
}
