bear1023/logistics-robot/firmware/Hardware/swith.c

#include "stm32f4xx.h"                  // Device header

void Swith_Init()
{
	RCC_AHB1PeriphClockCmd(RCC_AHB1Periph_GPIOC, ENABLE);			//开启GPIOC的时钟
	
	/*GPIO初始化*/
	GPIO_InitTypeDef GPIO_InitStructure;
	GPIO_InitStructure.GPIO_Mode = GPIO_Mode_IN;					
	GPIO_InitStructure.GPIO_Pin = GPIO_Pin_9;	        //配置PC9
	GPIO_InitStructure.GPIO_Speed = GPIO_Speed_50MHz;
	GPIO_InitStructure.GPIO_PuPd = GPIO_PuPd_UP;
	GPIO_Init(GPIOC, &GPIO_InitStructure);							//初始化GPIOC
}

uint8_t swith_out()
{   
   return GPIO_ReadInputDataBit(GPIOC, GPIO_Pin_9);
}
