bear1023/logistics-robot/firmware/can_ZDT/fifo.h

#ifndef __FIFO_H
#define __FIFO_H

#include "stm32f4xx.h"

/**********************************************************
***	Emm_V5.0步进闭环控制例程
***	编写作者：ZHANGDATOU
***	技术支持：张大头闭环伺服
***	淘宝店铺：https://zhangdatou.taobao.com
***	CSDN博客：http s://blog.csdn.net/zhangdatou666
***	qq交流群：262438510
**********************************************************/

typedef unsigned char bool;
#define true 1
#define false 0

#define 	FIFO_SIZE   128
typedef struct {
	uint16_t buffer[FIFO_SIZE];
	__IO uint8_t ptrWrite;
	__IO uint8_t ptrRead;
}FIFO_t;

extern __IO FIFO_t rxFIFO;

void fifo_initQueue(void);
void fifo_enQueue(uint16_t data);
uint16_t fifo_deQueue(void);
bool fifo_isEmpty(void);
uint16_t fifo_queueLength(void);

#endif
