bear1023/logistics-robot/(notices)

Notices in the files:
README.md:
License: MIT
